Challmymind/stm-keyboard/README.md

First iteration of my 30% keyboard PCB. </br>
Newest board with fixes [here](https://github.com/Challmymind/anvil_pcb).
