Challmymind/stm-keyboard/stm_skeyboard.kicad_pcb

## KiCad design stm_skeyboard.kicad_pcb (2024-06-08)

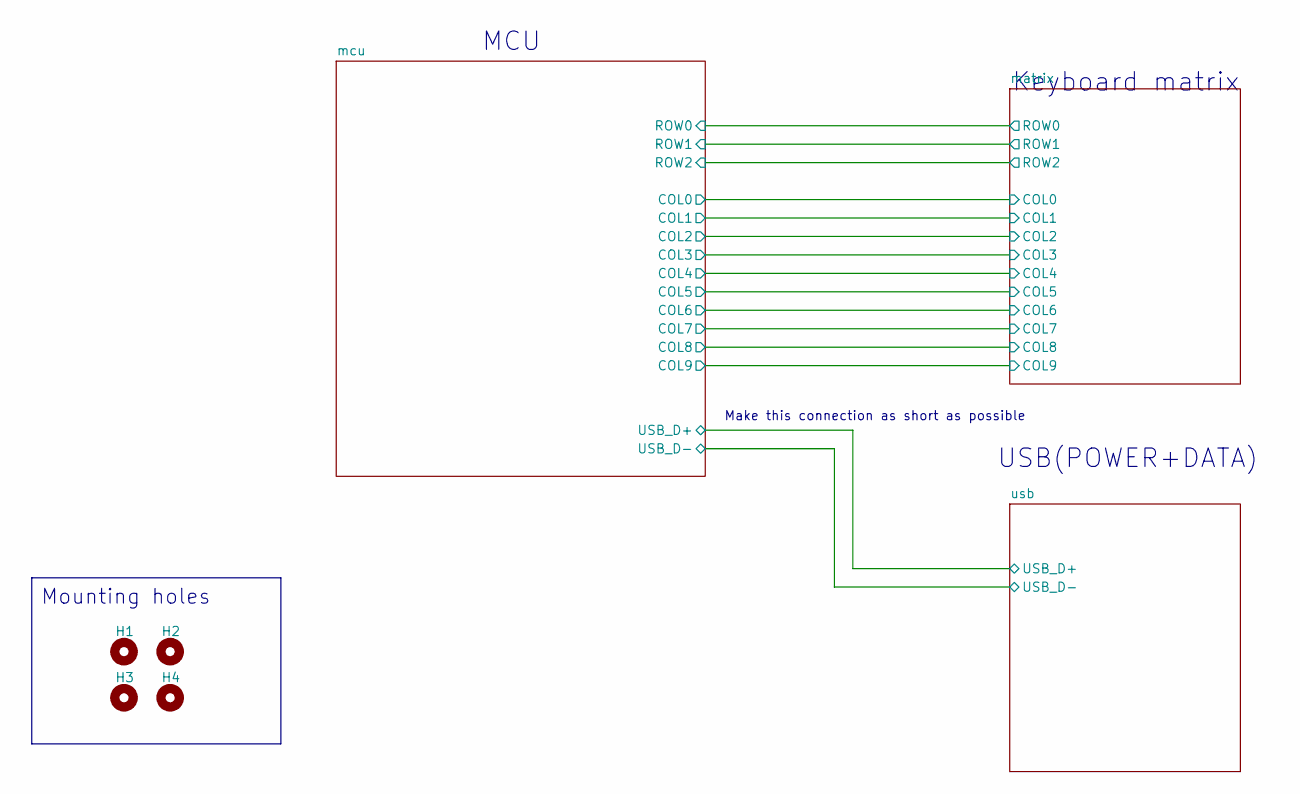
[picture p1: schematic stm_skeyboard.kicad_sch, Keyboard based on STM32L0xx]

Parts:
H1, H2, H3, H4: MountingHole; MountingHole_2.1mm

Notes on the sheet:
MCU
Keyboard matrix
Make this connection as short as possible
Mounting holes
USB(POWER+DATA)

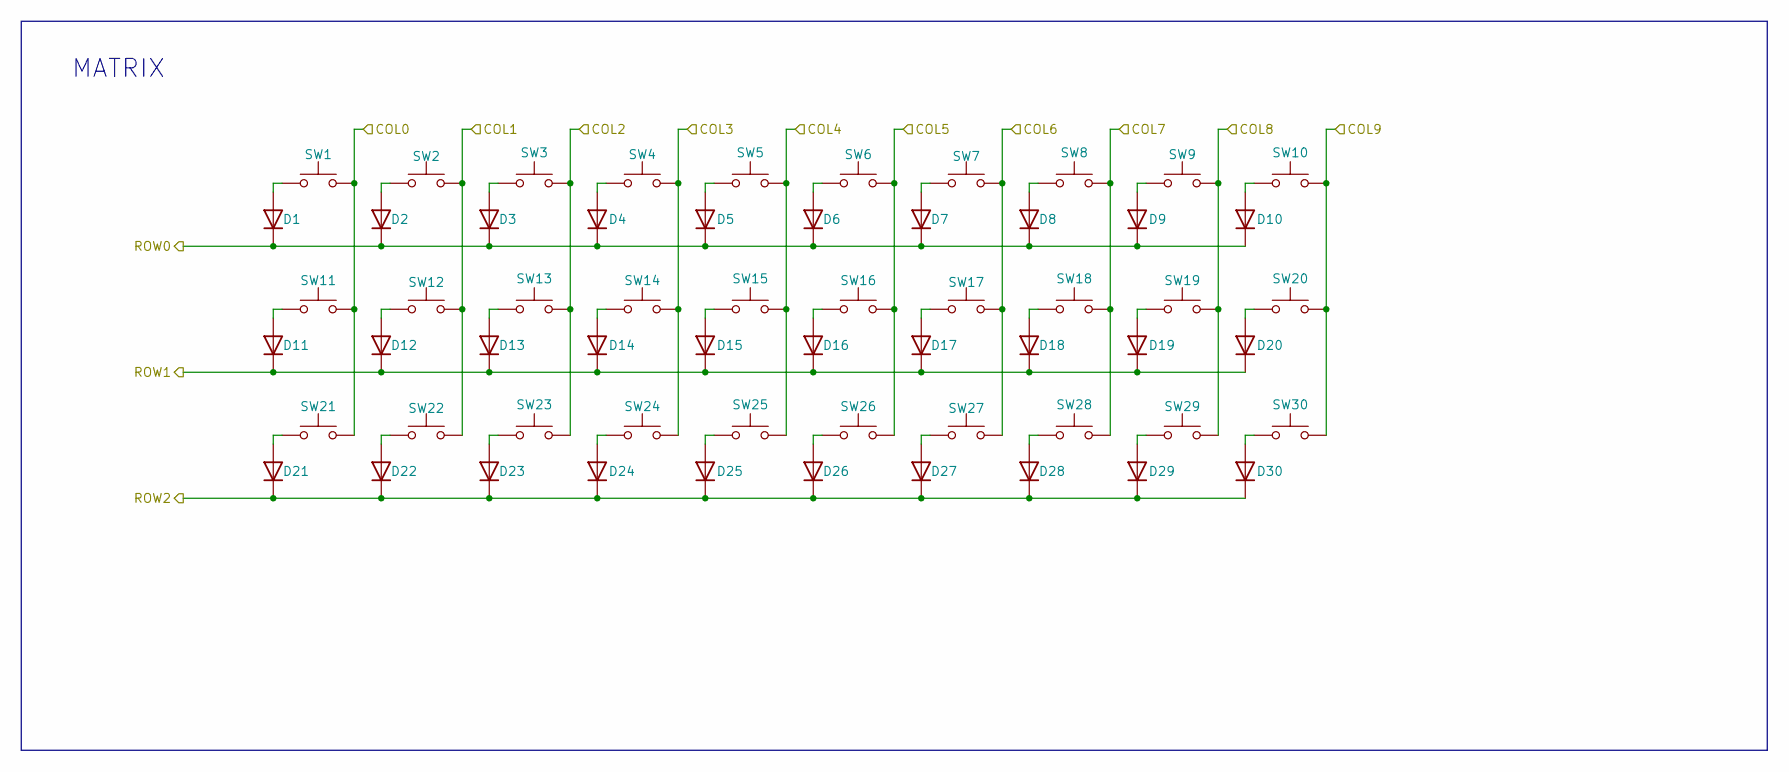
[picture p2: schematic matrix.kicad_sch, Keyboard based on STM32L0xx]

Parts:
D1, D2, D3, D4, D5, D6, D7, D8, D9, D10, D11, D12, D13, D14, D15, D16, D17, D18, D19, D20, D21, D22, D23, D24, D25, D26, D27, D28, D29, D30: D; D_SOD-123
SW1, SW2, SW3, SW4, SW5, SW6, SW7, SW8, SW9, SW10, SW11, SW12, SW13, SW14, SW15, SW16, SW17, SW18, SW19, SW20, SW21, SW22, SW23, SW24, SW25, SW26, SW27, SW28, SW29, SW30: SW_Push; SW_Cherry_MX_1.00u_PCB_no_support_stems

Connections:
/matrix/COL0: SW1.2, SW11.2, SW21.2; also elsewhere on the board
/matrix/COL1: SW2.2, SW12.2, SW22.2; also elsewhere on the board
/matrix/COL2: SW3.2, SW13.2, SW23.2; also elsewhere on the board
/matrix/COL3: SW4.2, SW14.2, SW24.2; also elsewhere on the board
/matrix/COL4: SW5.2, SW15.2, SW25.2; also elsewhere on the board
/matrix/COL5: SW6.2, SW16.2, SW26.2; also elsewhere on the board
/matrix/COL6: SW7.2, SW17.2, SW27.2; also elsewhere on the board
/matrix/COL7: SW8.2, SW18.2, SW28.2; also elsewhere on the board
/matrix/COL8: SW9.2, SW19.2, SW29.2; also elsewhere on the board
/matrix/COL9: SW10.2, SW20.2, SW30.2; also elsewhere on the board
/matrix/ROW0: D1.1 (K), D2.1 (K), D3.1 (K), D4.1 (K), D5.1 (K), D6.1 (K), D7.1 (K), D8.1 (K), D9.1 (K), D10.1 (K); also elsewhere on the board
/matrix/ROW1: D11.1 (K), D12.1 (K), D13.1 (K), D14.1 (K), D15.1 (K), D16.1 (K), D17.1 (K), D18.1 (K), D19.1 (K), D20.1 (K); also elsewhere on the board
/matrix/ROW2: D21.1 (K), D22.1 (K), D23.1 (K), D24.1 (K), D25.1 (K), D26.1 (K), D27.1 (K), D28.1 (K), D29.1 (K), D30.1 (K); also elsewhere on the board
unnamed: D1.2 (A), SW1.1
unnamed: D2.2 (A), SW2.1
unnamed: D3.2 (A), SW3.1
unnamed: D4.2 (A), SW4.1
unnamed: D5.2 (A), SW5.1
unnamed: D6.2 (A), SW6.1
unnamed: D7.2 (A), SW7.1
unnamed: D8.2 (A), SW8.1
unnamed: D9.2 (A), SW9.1
unnamed: D10.2 (A), SW10.1
unnamed: D11.2 (A), SW11.1
unnamed: D12.2 (A), SW12.1
unnamed: D13.2 (A), SW13.1
unnamed: D14.2 (A), SW14.1
unnamed: D15.2 (A), SW15.1
unnamed: D16.2 (A), SW16.1
unnamed: D17.2 (A), SW17.1
unnamed: D18.2 (A), SW18.1
unnamed: D19.2 (A), SW19.1
unnamed: D20.2 (A), SW20.1
unnamed: D21.2 (A), SW21.1
unnamed: D22.2 (A), SW22.1
unnamed: D23.2 (A), SW23.1
unnamed: D24.2 (A), SW24.1
unnamed: D25.2 (A), SW25.1
unnamed: D26.2 (A), SW26.1
unnamed: D27.2 (A), SW27.1
unnamed: D28.2 (A), SW28.1
unnamed: D29.2 (A), SW29.1
unnamed: D30.2 (A), SW30.1

Notes on the sheet:
MATRIX

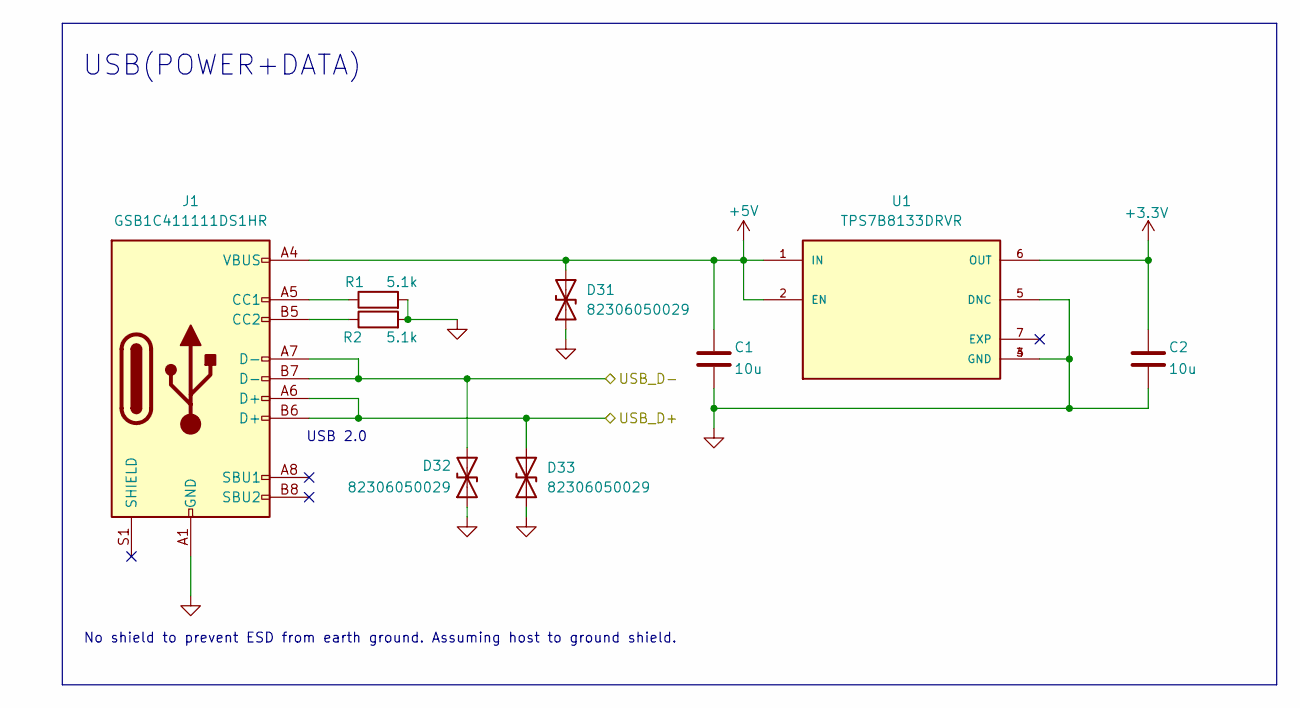
[picture p3: schematic usb.kicad_sch, Keyboard based on STM32L0xx]

Parts:
C1, C2: 10u; C_0603_1608Metric
D31, D32, D33: 82306050029; D_0603_1608Metric
J1: GSB1C411111DS1HR; AMPHENOL_GSB1C411111DS1HR
R1, R2: 5.1k; R_0402_1005Metric
U1: TPS7B8133DRVR; SON65P200X200X80-7N; PARTREV April 2020

Connections:
+3.3V: C2.1, U1.6 (OUT); also elsewhere on the board
+5V: C1.1, D31.2 (A2), J1.A4 (VBUS), J1.A4B9, J1.A9 (VBUS), J1.B4 (VBUS), J1.B4A9, J1.B9 (VBUS), U1.1 (IN), U1.2 (EN)
/mcu/USB_D+: D33.2 (A2), J1.A6 (D+), J1.B6 (D+); also elsewhere on the board
/mcu/USB_D-: D32.2 (A2), J1.A7 (D-), J1.B7 (D-); also elsewhere on the board
GND: C1.2, C2.2, D31.1 (A1), D32.1 (A1), D33.1 (A1), J1.A1 (GND), J1.A1B12, J1.A12 (GND), J1.B1 (GND), J1.B1A12, J1.B12 (GND), R1.2, R2.2, U1.3 (GND), U1.4 (GND), U1.5 (DNC); also elsewhere on the board
unnamed: J1.A5 (CC1), R1.1
unnamed: J1.B5 (CC2), R2.1

Notes on the sheet:
USB(POWER+DATA)
USB 2.0
No shield to prevent ESD from earth ground. Assuming host to ground shield.

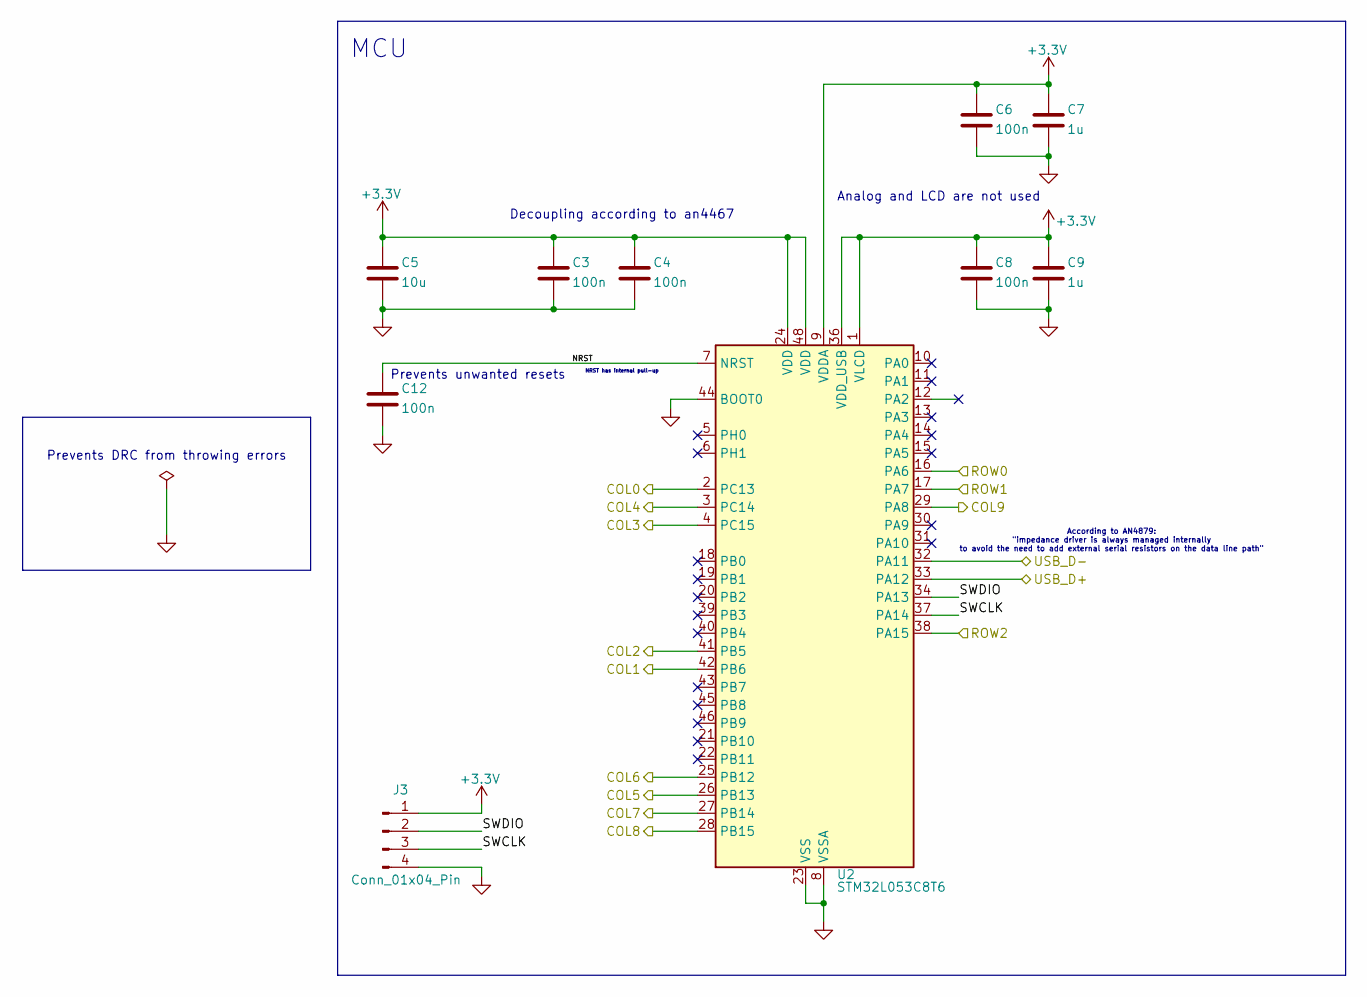
[picture p4: schematic mcu.kicad_sch, Keyboard based on STM32L0xx]

Parts:
C3, C4, C6, C8, C12: 100n; C_0402_1005Metric
C5: 10u; C_0603_1608Metric
C7, C9: 1u; C_0402_1005Metric
J3: Conn_01x04_Pin; PinHeader_1x04_P2.54mm_Vertical
U2: STM32L053C8T6; LQFP-48_7x7mm_P0.5mm

Connections:
+3.3V: C3.1, C4.1, C5.1, C6.1, C7.1, C8.1, C9.1, J3.1, U2.1 (VLCD), U2.9 (VDDA), U2.24 (VDD), U2.36 (VDD_USB), U2.48 (VDD); also elsewhere on the board
/matrix/COL0: U2.2 (PC13); also elsewhere on the board
/matrix/COL1: U2.42 (PB6); also elsewhere on the board
/matrix/COL2: U2.41 (PB5); also elsewhere on the board
/matrix/COL3: U2.4 (PC15); also elsewhere on the board
/matrix/COL4: U2.3 (PC14); also elsewhere on the board
/matrix/COL5: U2.26 (PB13); also elsewhere on the board
/matrix/COL6: U2.25 (PB12); also elsewhere on the board
/matrix/COL7: U2.27 (PB14); also elsewhere on the board
/matrix/COL8: U2.28 (PB15); also elsewhere on the board
/matrix/COL9: U2.29 (PA8); also elsewhere on the board
/matrix/ROW0: U2.16 (PA6); also elsewhere on the board
/matrix/ROW1: U2.17 (PA7); also elsewhere on the board
/matrix/ROW2: U2.38 (PA15); also elsewhere on the board
/mcu/NRST: C12.1, U2.7 (NRST)
/mcu/SWCLK: J3.3, U2.37 (PA14)
/mcu/SWDIO: J3.2, U2.34 (PA13)
/mcu/USB_D+: U2.33 (PA12); also elsewhere on the board
/mcu/USB_D-: U2.32 (PA11); also elsewhere on the board
GND: C3.2, C4.2, C5.2, C6.2, C7.2, C8.2, C9.2, C12.2, J3.4, U2.8 (VSSA), U2.23 (VSS), U2.35 (VSS), U2.44 (BOOT0), U2.47 (VSS); also elsewhere on the board

Notes on the sheet:
Decoupling according to an4467
Analog and LCD are not used
Prevents unwanted resets
Prevents DRC from throwing errors
According to AN4879: "impedance driver is always managed internally to avoid the need to add external serial resistors on the data line path"
NRST has internal pull-up
MCU

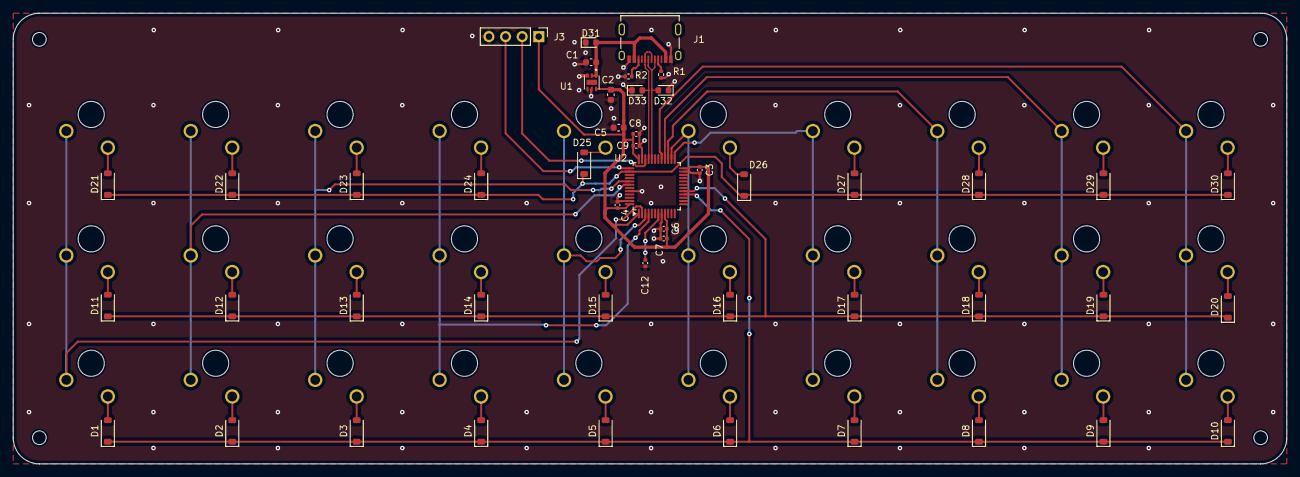
[picture p5: board stm_skeyboard.kicad_pcb from above]

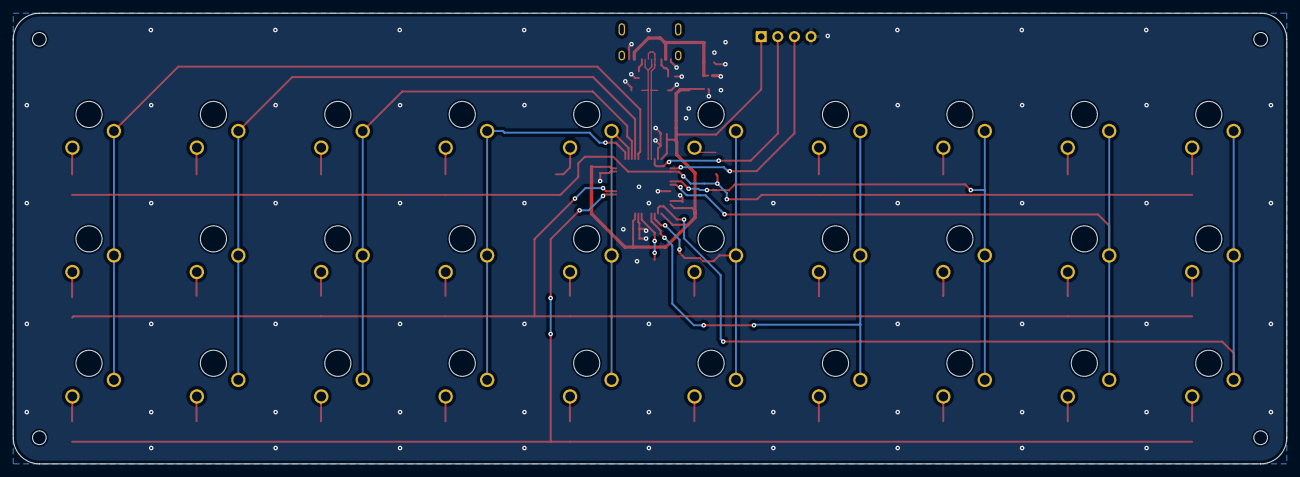
[picture p6: board stm_skeyboard.kicad_pcb from below]

Board: 2 copper layers, 195.0 x 69.0 mm, 83 parts (30 on the bottom side), 53 nets.
