Challmymind/stm-keyboard/(commit log)

2024-04-28 initial schematics
    [matrix.kicad_sch, mcu.kicad_sch, stm_skeyboard.kicad_pcb, stm_skeyboard.kicad_sch]
2024-04-28 adjust paths for kicanvas
    [matrix.kicad_sch, mcu.kicad_sch, stm_skeyboard.kicad_sch]
2024-04-28 moved usb to another sheet, cleared ERC violations
    [mcu.kicad_sch, stm_skeyboard.kicad_sch, usb.kicad_sch]
2024-04-29 completed 0.1 schematic design
    [matrix.kicad_sch, mcu.kicad_sch, stm_skeyboard.kicad_pcb, stm_skeyboard.kicad_sch, usb.kicad_sch]
2024-05-03 switched to bigger matrix, adjusted mcu pins, started pcb layout
    [matrix.kicad_sch, mcu.kicad_sch, stm_skeyboard.kicad_pcb, stm_skeyboard.kicad_sch, usb.kicad_sch]
2024-05-06 added 3d models, completed 0.1
    [matrix.kicad_sch, stm_skeyboard.kicad_pcb, stm_skeyboard.kicad_sch]
2024-05-06 added routing
    [matrix.kicad_sch, mcu.kicad_sch, stm_skeyboard.kicad_pcb]
2024-05-13 repair decoupling and fill front layer
    [stm_skeyboard.kicad_pcb]
2024-05-27 re-done whole pcb
    [matrix.kicad_sch, mcu.kicad_sch, stm_skeyboard.kicad_pcb, usb.kicad_sch]
2024-06-08 added ESD protection, re-wired matrix
    [matrix.kicad_sch, mcu.kicad_sch, stm_skeyboard.kicad_pcb, usb.kicad_sch]
